al-nafisah/llm-kv260/docs/img/engine.pdf

## The engine on one board

Every token, the FPGA streams this board's quarter of the weights from DDR4 and multiplies it as it passes

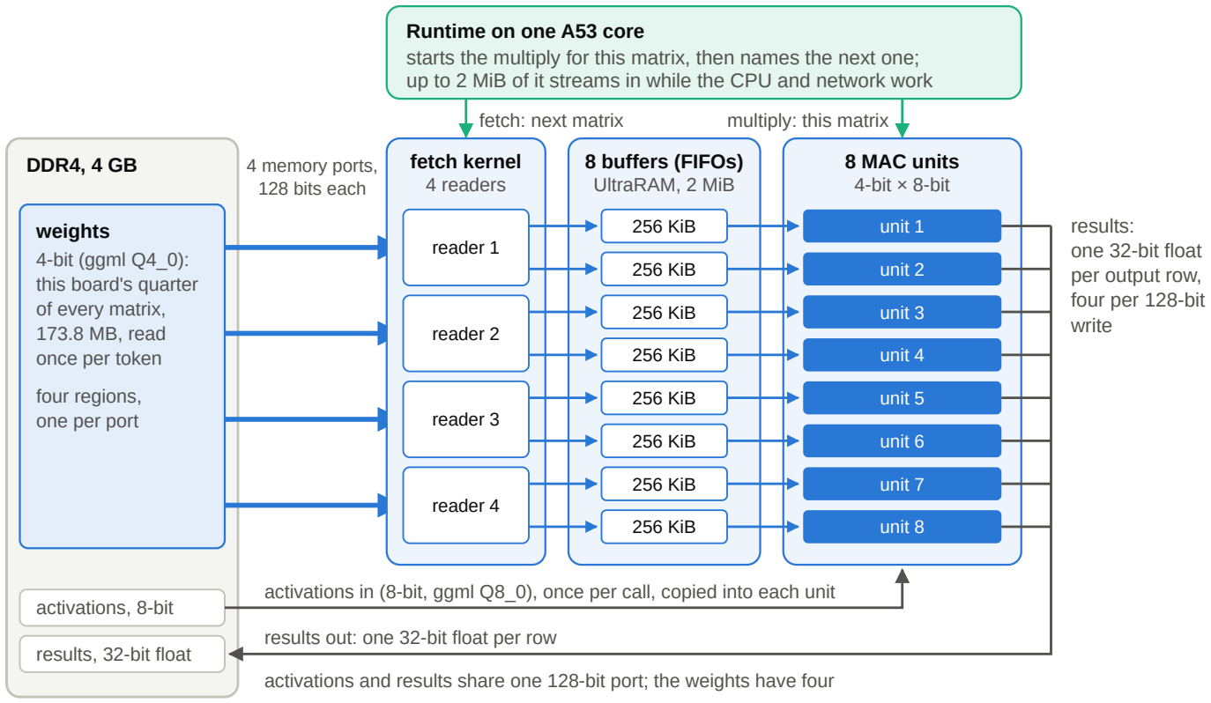
[picture p2: figure]
Runtime on one A53 core; fetch: next matrix; multiply: this matrix; DDR4, 4 GB; weights 4-bit (ggml Q4_0): this board's quarter of every matrix, 173.8 MB, read once per token; four regions, one per port; activations, 8-bit; results, 32-bit float; 4 memory ports, 128 bits each; fetch kernel 4 readers; reader 1; reader 2; reader 3; reader 4; 8 buffers (FIFOs) UltraRAM, 2 MiB; 256 KiB; 8 MAC units 4-bit × 8-bit; unit 1; unit 2; unit 3; unit 4; unit 5; unit 6; unit 7; unit 8; results out: one 32-bit float per row; results: one 32-bit float per output row, four per 128-bit write

starts the multiply for this matrix, then names the next one; up to 2 MiB of it streams in while the CPU and network work

activations in (8-bit, ggml Q8_0), once per call, copied into each unit

activations and results share one 128-bit port; the weights have four

Inside each MAC unit, for every block of 32 weights

32 × (4-bit × 8-bit) | integer sum | × two scales, 32-bit float | add into lane (block mod 8) | end of row: 8 lanes, fixed tree

The integer sum is exact in any order and the float order is fixed by the contract (src/llm_kv260/q4_0.py),
so the output is checked against it byte for byte: 9 of 9 test cases pass on each of the four boards (bench_gemv2).

gemv2 on the XCK26 (Vitis HLS and Vivado 2022.2), 250 MHz clock. Each reader deals alternate 144-byte chunks to its two buffers. Sources: hls/gemv2/, hw/kv260_gemv2/build.tcl, board/tp/tp_llama.cpp. Weights are a load-time copy of the GGUF's Q4_0 blocks.
