al-nafisah/llm-kv260/docs/img/scaling.pdf

## Rate and energy per token on 1, 2 and 4 boards

Each dot is one 400-token run; the open diamond is the same board without its engine (different software)

this project: runtime + FPGA engine, each run | same board, CPU only: llama.cpp, mean of 3 runs

Decode rate

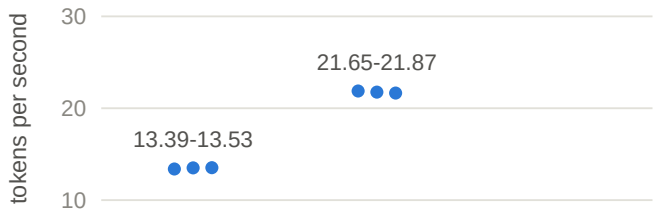
[picture p3: figure]
tokens per second

0

40

1 board

2 boards

4 boards

34.71-36.69

CPU only: 2.88 ± 0.07

Energy per generated token

0.0

0.5

1.0

1.5

2.0
joules per token (module power)

1 board
6.16-6.25 W

0.459-0.462 J

2 boards
11.59-11.68 W

0.530-0.539 J

4 boards
22.39-22.76 W

0.620-0.645 J

CPU only: 1.83 J at 5.28 W

Llama-3.2-1B-Instruct, every weight matrix ggml Q4_0, 400 generated tokens. Boards: run-tp.sh, 24-token prompt (positions 24-423), greedy, 3 runs each; medians 13.51, 21.75, 36.57 tokens/s, 1.61x on two boards and 2.71x on four.
CPU only: llama-bench on board 1's four A53 cores, tg400 from an empty context (positions 0-399), 2.88 ± 0.07 (mean ± s.d.). Power: the INA260 on each running K26 module, about 10 samples/s; carrier cards, fans, power supplies and the
switch are not measured. 2026-11-04, buildlog 0013; source: evidence/0013-tp-runs.txt, -power-*, -cpu-llama-bench.txt.
