al-nafisah/llm-kv260/docs/img/system.pdf

## Four boards, one token stream

Each board holds a quarter of every weight matrix; all four work on the same token at the same time

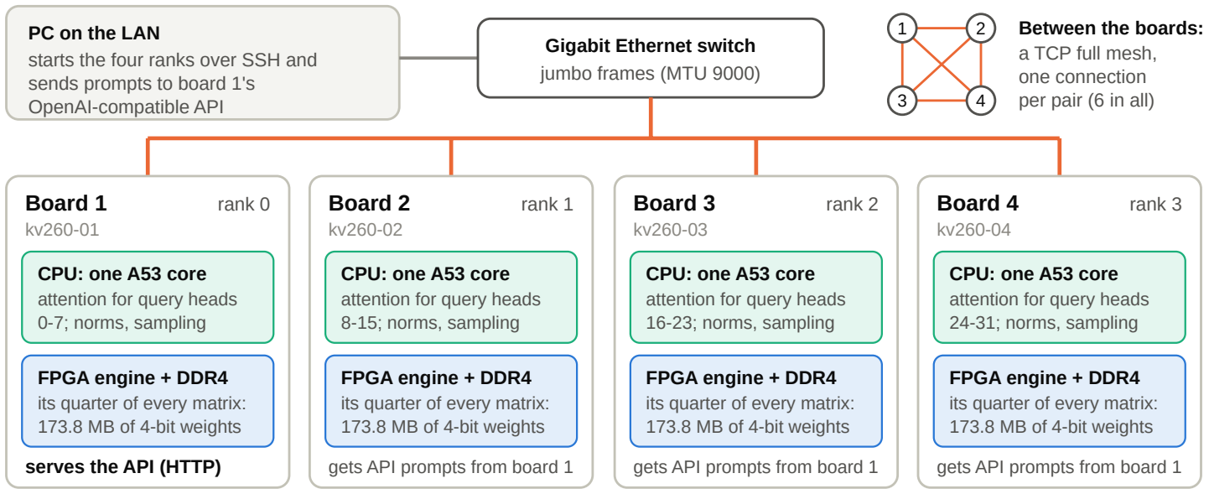
[picture p4: figure]
PC on the LAN starts the four ranks over SSH and sends prompts to board 1's OpenAI-compatible API; Gigabit Ethernet switch jumbo frames (MTU 9000); Between the boards: a TCP full mesh, one connection per pair (6 in all); Board 1; rank 0; CPU: one A53 core attention for query heads 0-7; norms, sampling; FPGA engine + DDR4 its quarter of every matrix: 173.8 MB of 4-bit weights; serves the API (HTTP); Board 2; rank 1; CPU: one A53 core attention for query heads 8-15; norms, sampling; gets API prompts from board 1; Board 3; rank 2; CPU: one A53 core attention for query heads 16-23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

How a weight matrix is split across the four boards

1
2
3
4
× | =
weights | input output

By output rows
q, k, v, gate, up and the
output head (lm_head):
each board computes its own quarter of the outputs,
with no all-reduce
1 | 2 | 3 | 4 | × | =
weights | input output

By input columns
attention output, FFN down: each board has a partial sum of every output; an all-reduce adds the four in board order, the same way on every board
then once per token: | output head (lm_head) | argmax exchange | next token, the same on all four boards

33 exchanges per token: 2 all-reduces in each of the 16 layers, plus 1 argmax exchange.
engine (FPGA) | exchange (network) | CPU (one A53 core)

Llama-3.2-1B-Instruct, every weight matrix ggml Q4_0: 695.1 MB of weights per token, 173.8 MB per board on four. Runtime: board/tp/tp_llama.cpp. Partial sums are added in rank order on every board, so all four hold the same hidden state.
