al-nafisah/llm-kv260/docs/img/token.pdf

## Where one token's time goes

Time per generated token on board 1 (rank 0), three runs for each board count

Engine (matrix-vector calls on the FPGA) | Exchange (network) | CPU (one A53 core)
0 | 10 | 20 | 30 | 40 | 50 | 60 | 70 | 80
milliseconds per generated token

### 1 board

exchange 0.2 ms

run 1 | 53.4 | 22.9 | 13.39 tokens/s
run 2 | 53.4 | 22.1 | 13.51 tokens/s
run 3 | 53.4 | 22.0 | 13.53 tokens/s

### 2 boards

run 1 | 22.4 | 12.4 | 11.9 | 21.87 tokens/s
run 2 | 22.4 | 12.7 | 11.8 | 21.75 tokens/s
run 3 | 22.4 | 12.9 | 11.8 | 21.65 tokens/s

### 4 boards

run 1 | 10.0 | 12.7 | 6.3 | 34.71 tokens/s
run 2 | 10.0 | 11.4 | 6.1 | 36.69 tokens/s
run 3 | 10.0 | 11.7 | 5.9 | 36.57 tokens/s

Llama-3.2-1B-Instruct, every weight matrix ggml Q4_0. run-tp.sh, 400 tokens generated after a 24-token prompt (positions 24-423), greedy; gemv2 bitstream at 250 MHz; rank 0's buckets: all 423 forwards,
prompt included, over the 400 tokens (about 6% high). Engine time includes preparing each call's input on the CPU. 2026-11-04, buildlog 0013; source: evidence/0013-tp-runs.txt.
