al-nafisah/llm-kv260/docs/img/engine.png

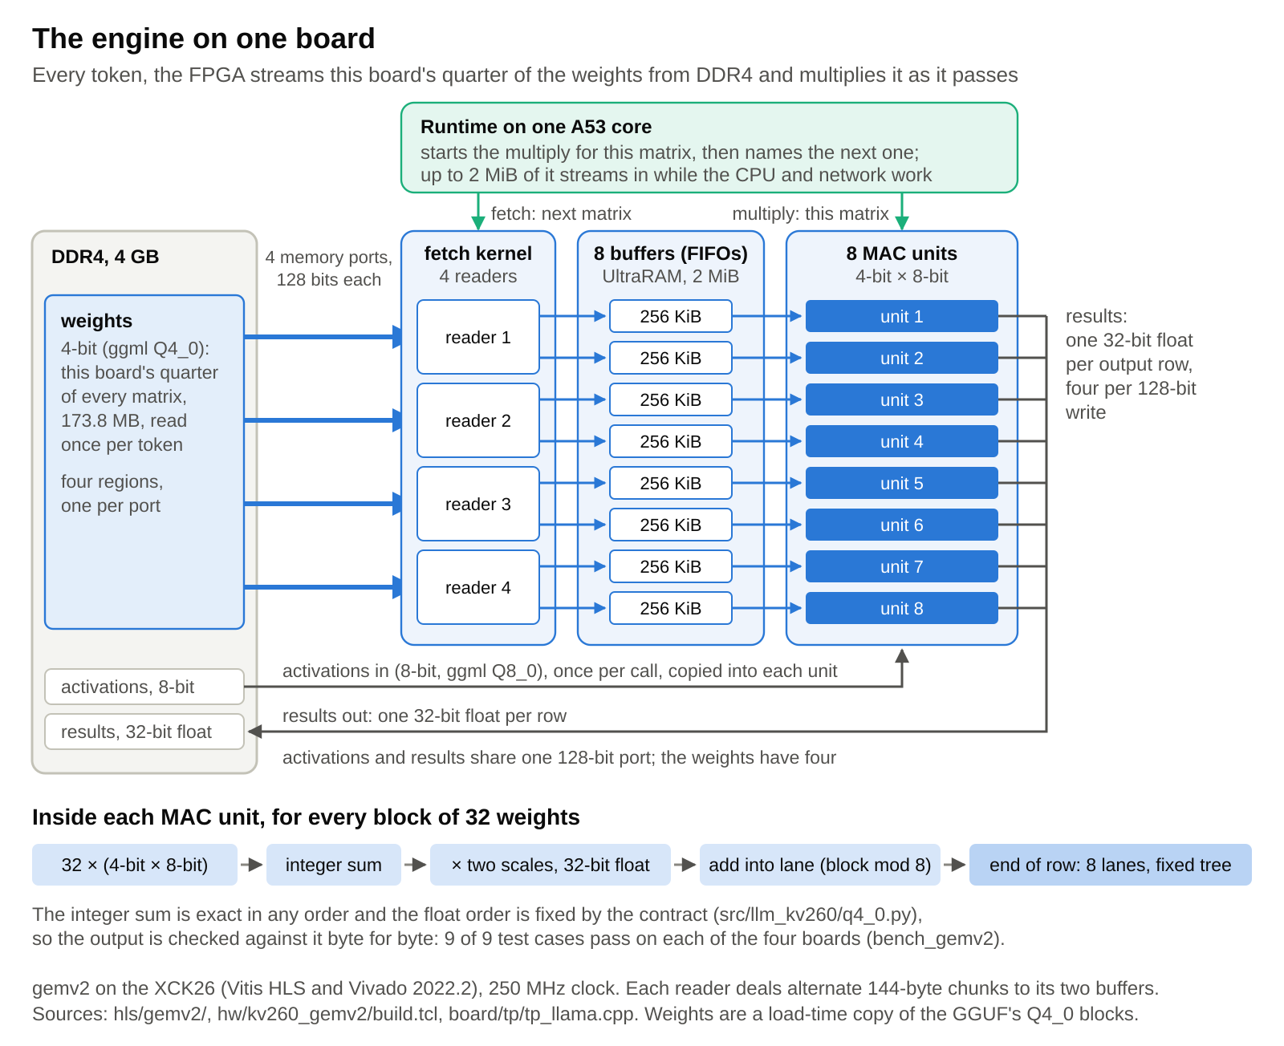
docs/img/engine.png
