al-nafisah/llm-kv260/docs/img/scaling.png

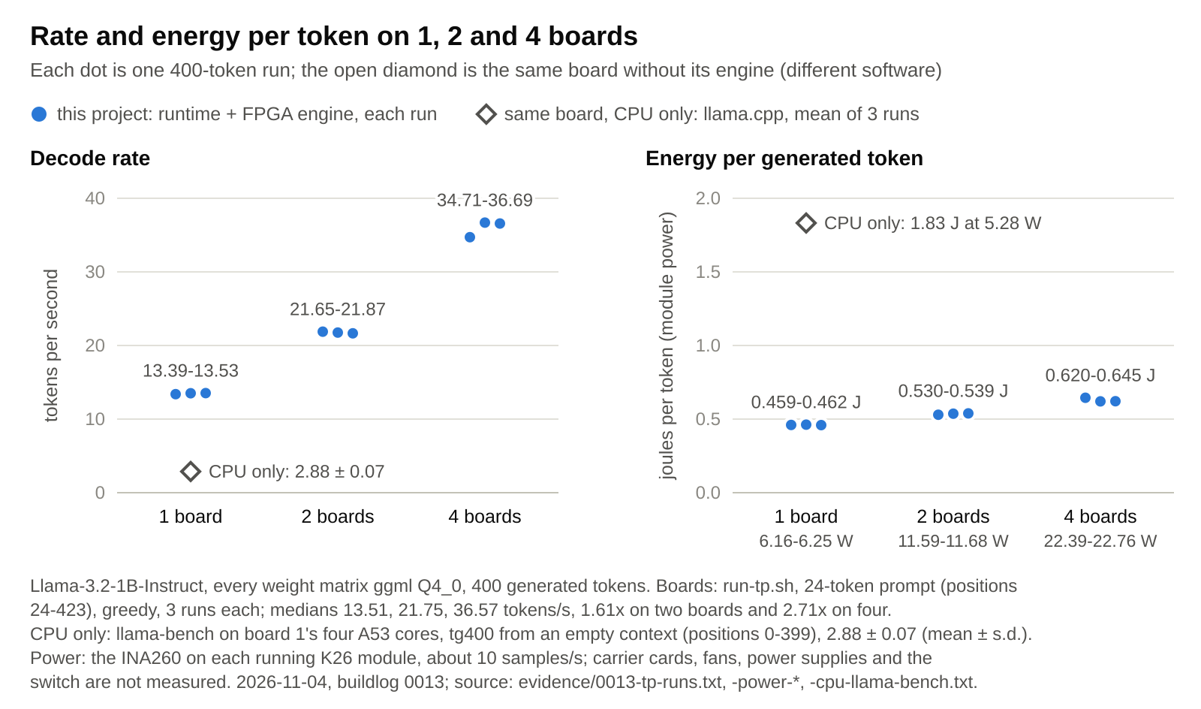
docs/img/scaling.png
