al-nafisah/llm-kv260/docs/img/system.png

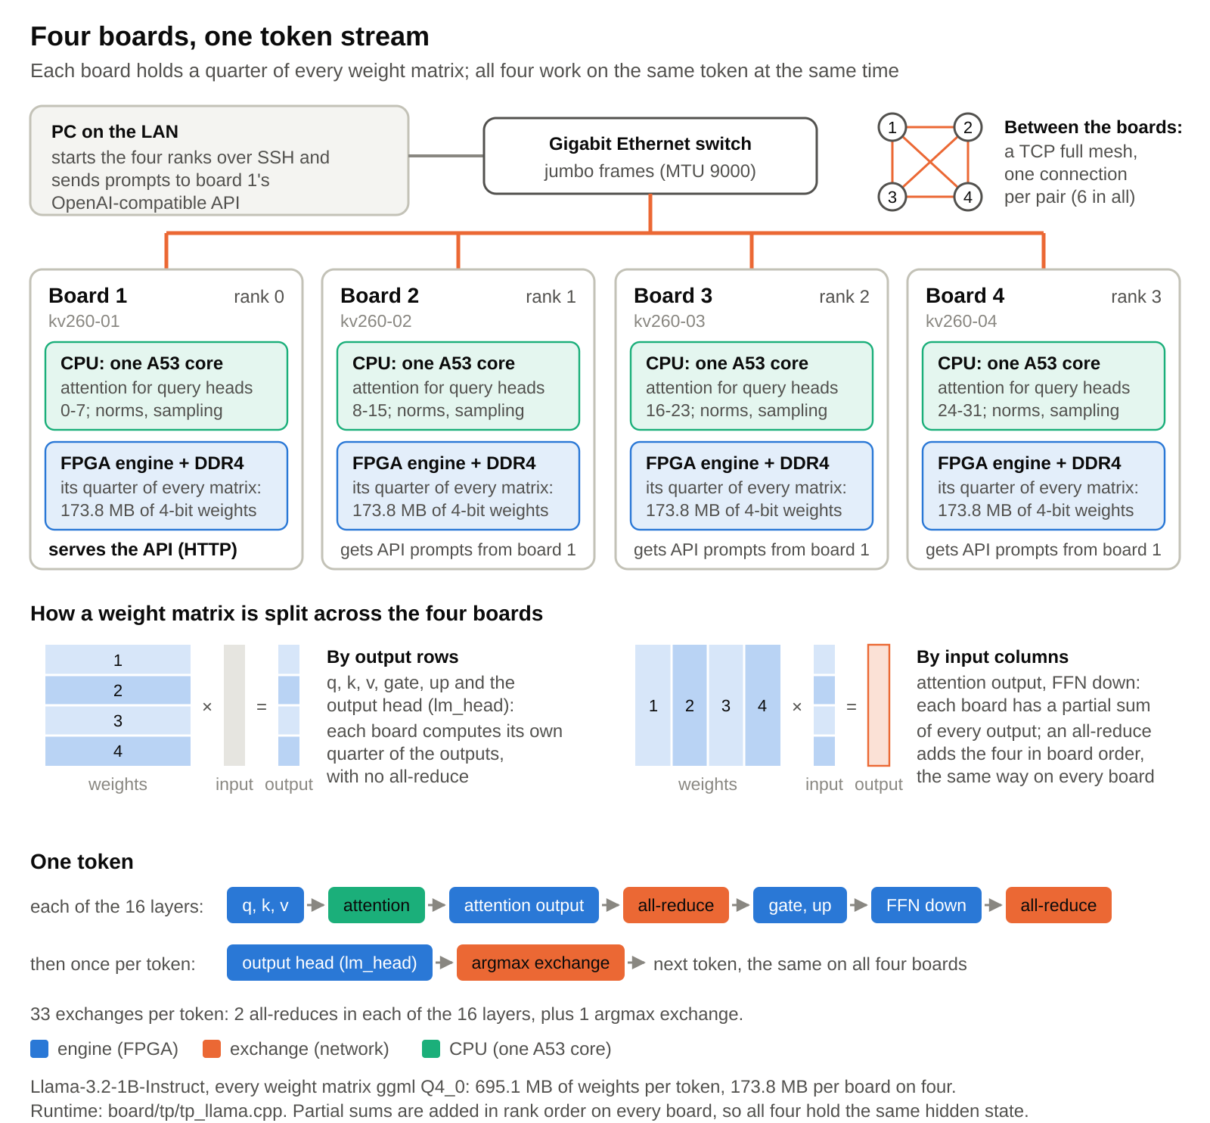
docs/img/system.png
