al-nafisah/llm-kv260/docs/img/token.png

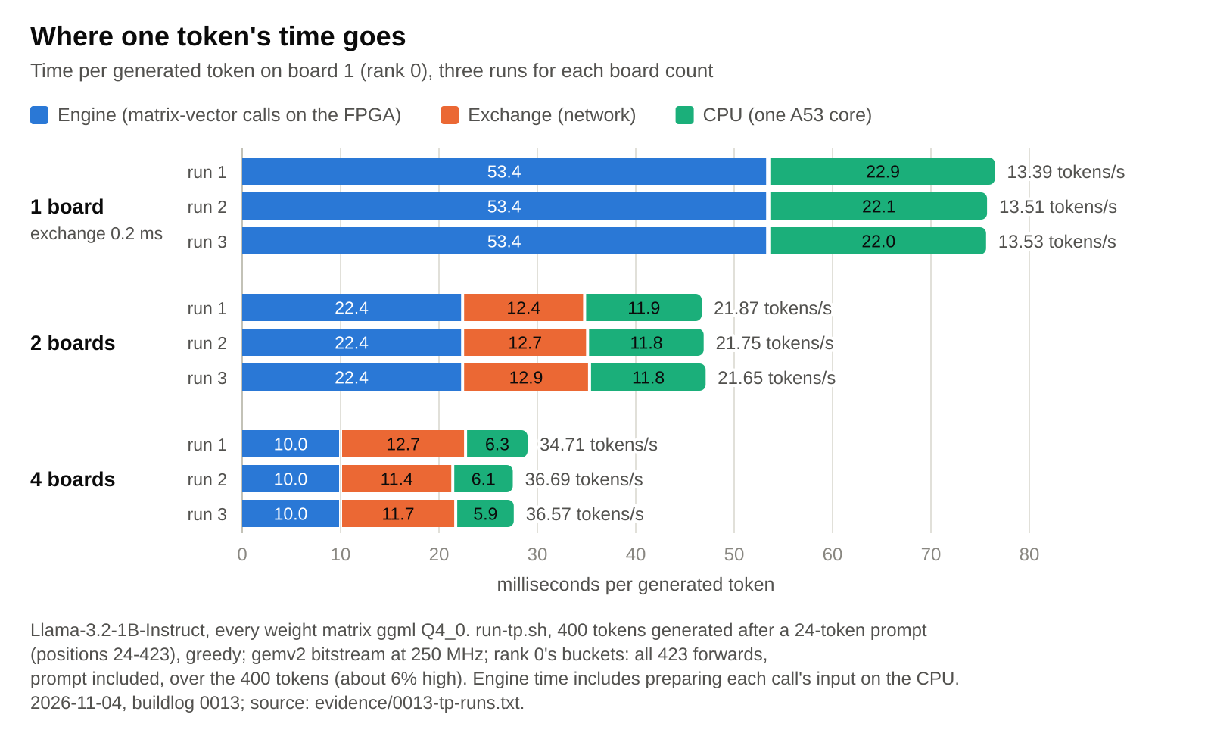
docs/img/token.png
