al-nafisah/llm-kv260/enclosure/previews/kv_fascia.png

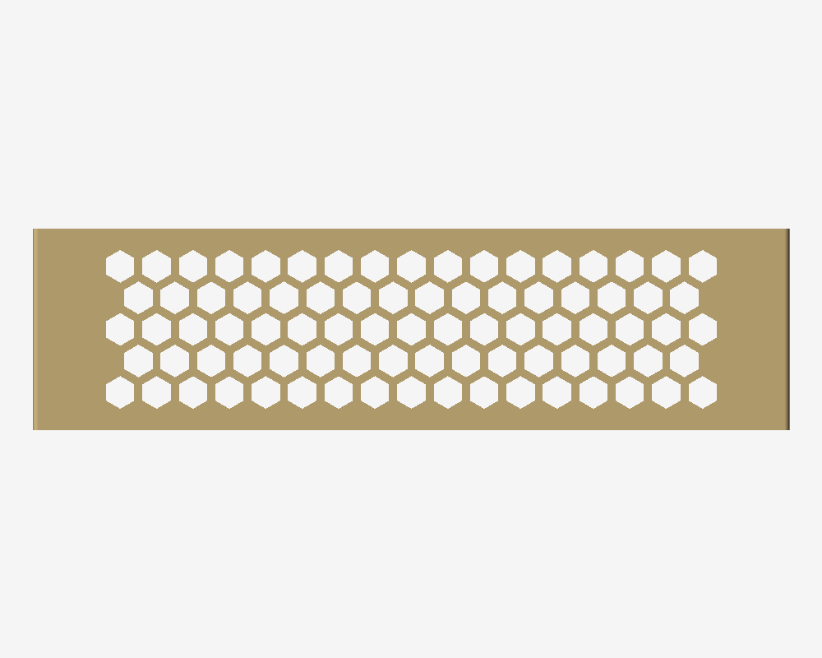
enclosure/previews/kv_fascia.png
