al-nafisah/llm-kv260/enclosure/previews/kv_tray.png

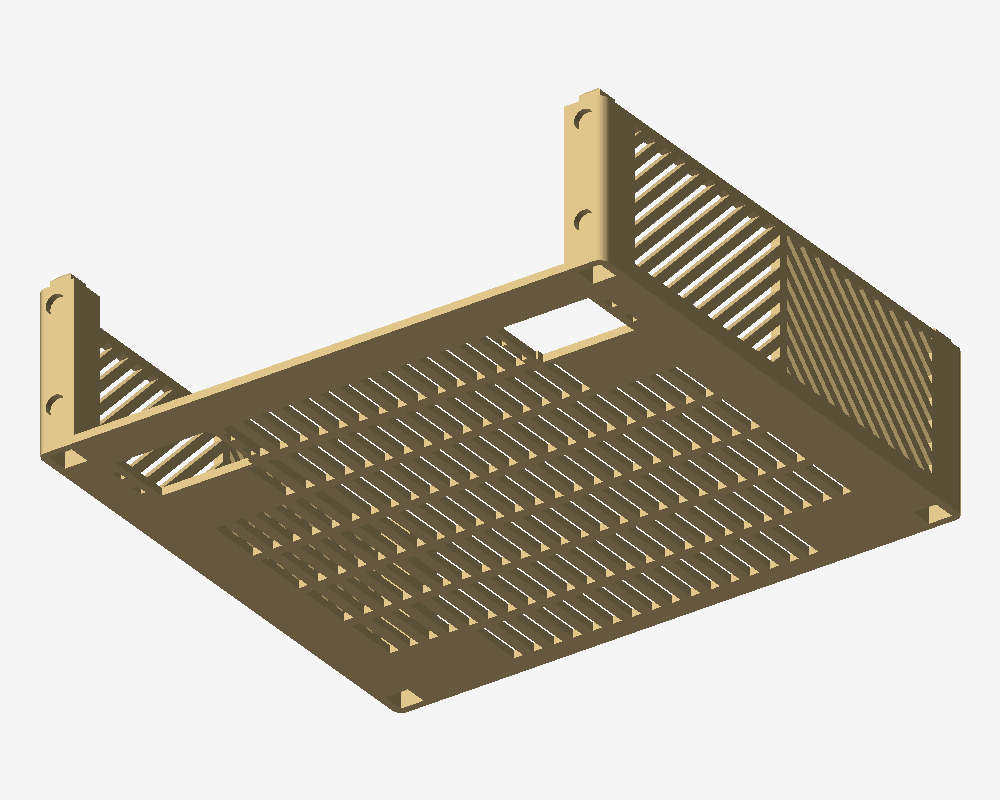
enclosure/previews/kv_tray.png
