al-nafisah/llm-kv260/enclosure/previews/kv_tray_side.png

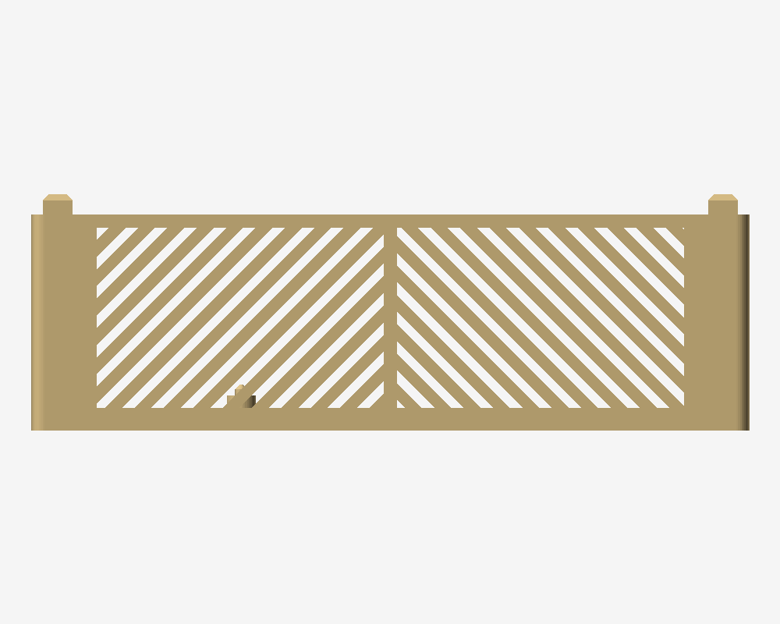
enclosure/previews/kv_tray_side.png
