al-nafisah/llm-kv260/enclosure/previews/switch_tray.png

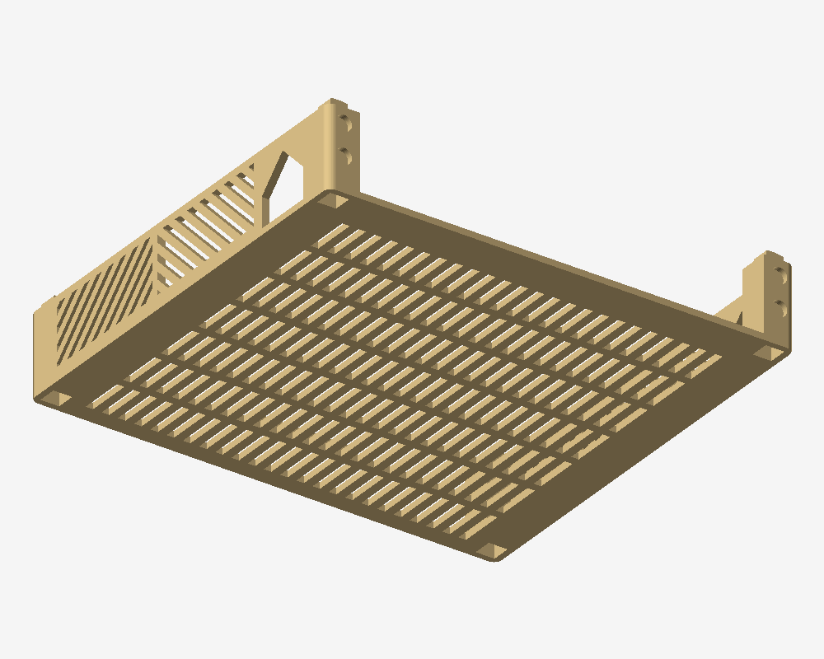
enclosure/previews/switch_tray.png
