al-nafisah/llm-kv260/enclosure/previews/top_cap.png

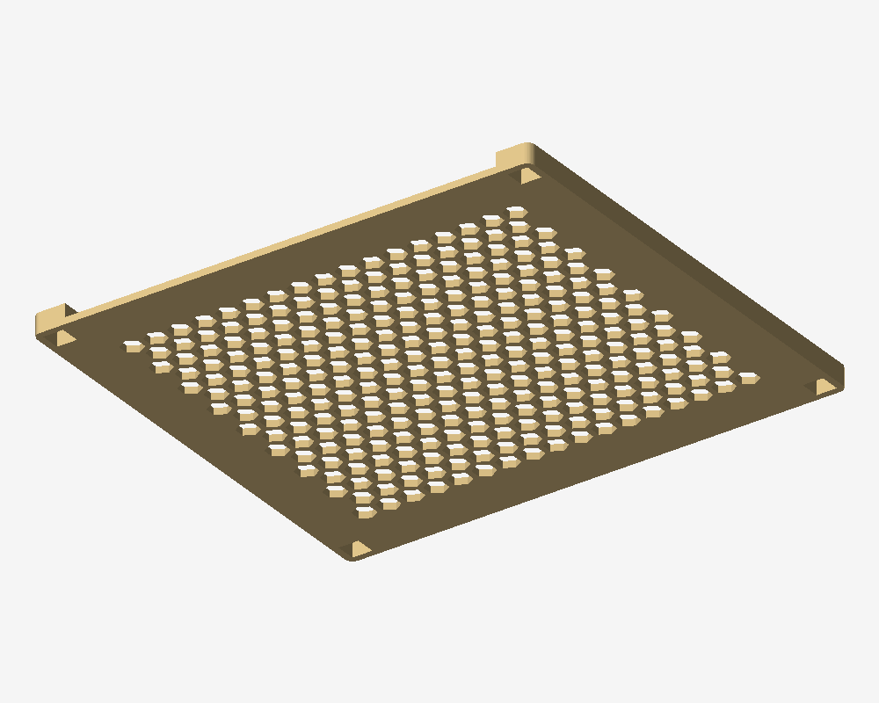
enclosure/previews/top_cap.png
