al-nafisah/llm-kv260/enclosure/stl/kv_tray.stl

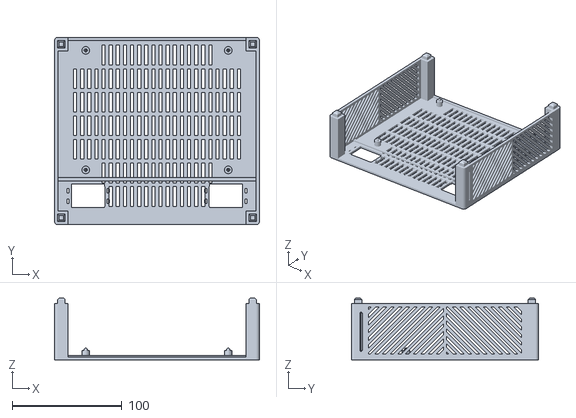
[picture p14: CAD file, 2026-09-29]
enclosure/stl/kv_tray.stl
187.0 x 171.0 x 56.5
