al-nafisah/llm-kv260/enclosure/stl/top_cap.stl

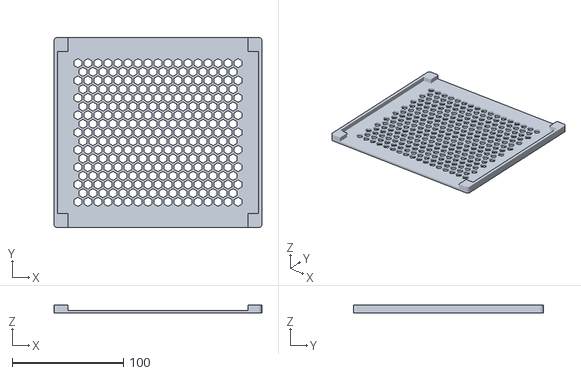
[picture p15: CAD file, 2026-09-29]
enclosure/stl/top_cap.stl
187.0 x 171.0 x 7.50
