al-nafisah/llm-kv260/enclosure/stl/switch_tray.stl

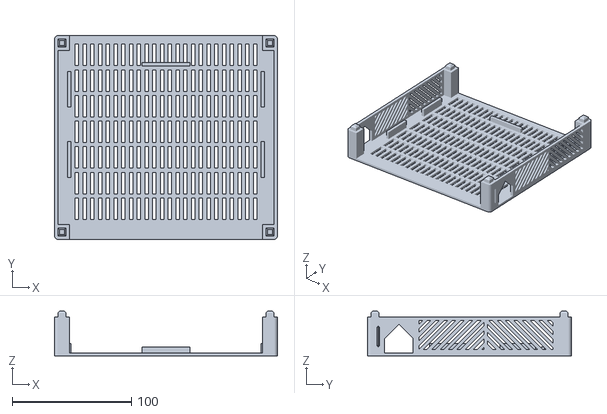
[picture p16: CAD file, 2026-09-29]
enclosure/stl/switch_tray.stl
187.0 x 171.0 x 37.5
