al-nafisah/llm-kv260/enclosure/stl/kv_fascia.stl

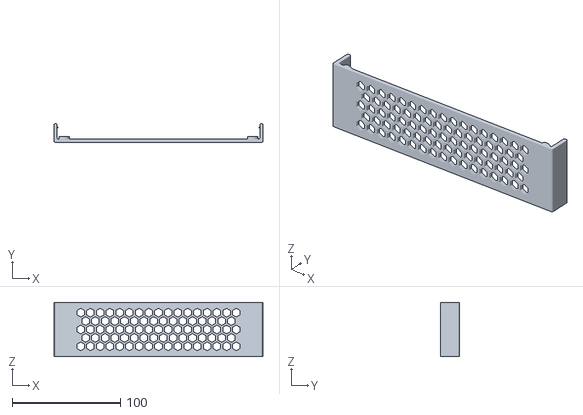
[picture p17: CAD file, 2026-09-29]
enclosure/stl/kv_fascia.stl
193.5 x 17.3 x 50.0
