al-nafisah/llm-kv260/enclosure/stl/sw_fascia.stl

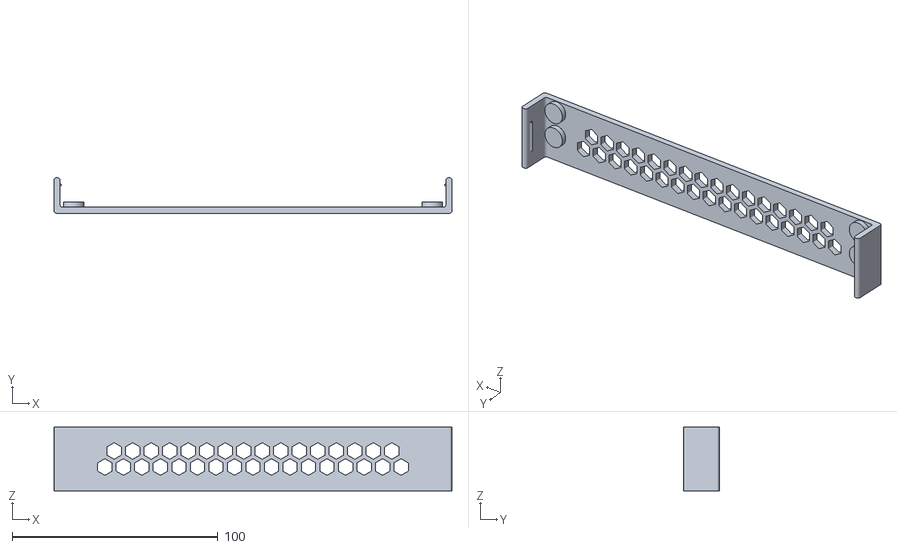
[picture p18: CAD file, 2026-09-29]
enclosure/stl/sw_fascia.stl
193.5 x 17.3 x 31.0
