al-nafisah/llm-kv260/enclosure/previews/assembly_front.png

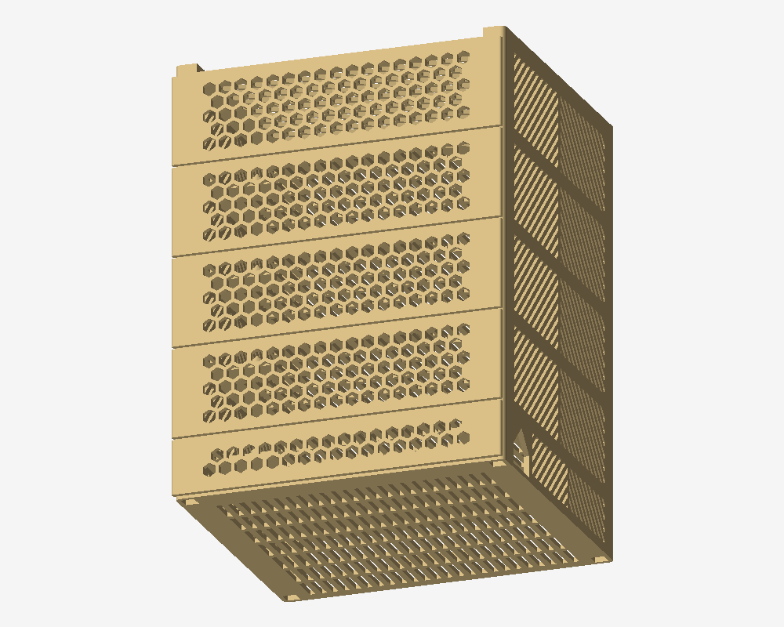
enclosure/previews/assembly_front.png
