al-nafisah/llm-kv260/enclosure/previews/assembly_iso.png

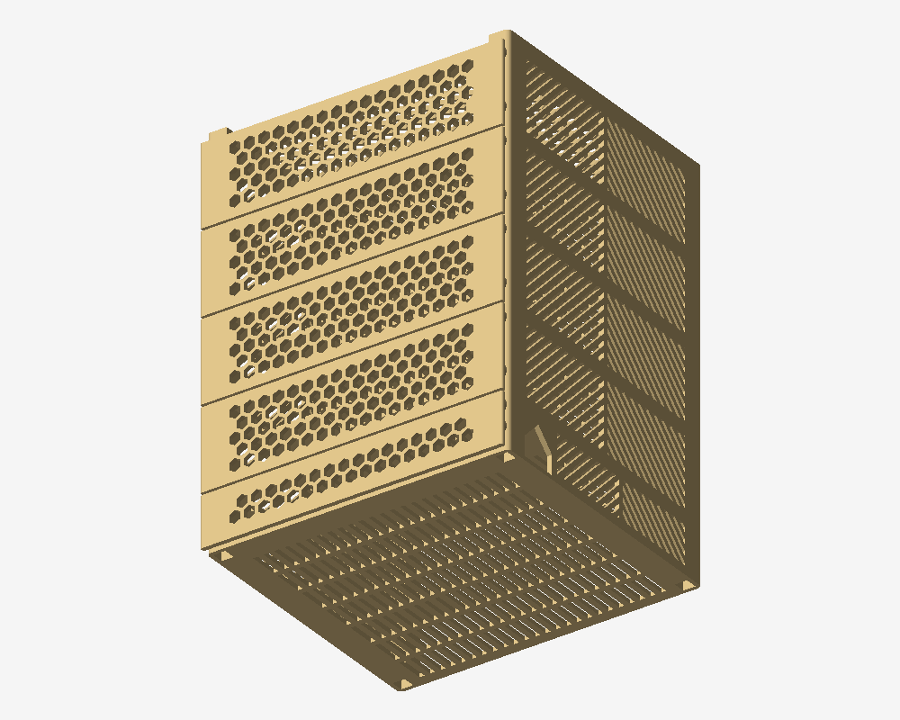
enclosure/previews/assembly_iso.png
