al-nafisah/llm-kv260/enclosure/previews/print_layout.png

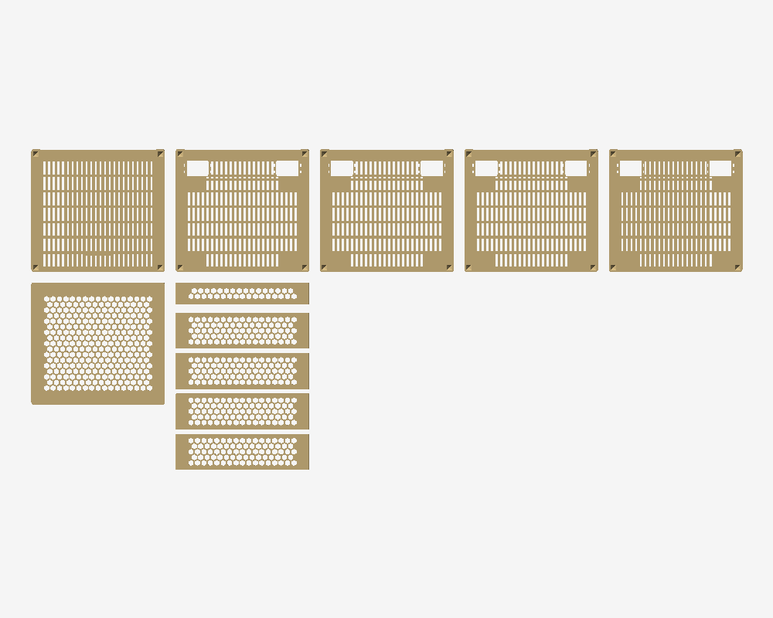
enclosure/previews/print_layout.png
