al-nafisah/llm-kv260/(commit log)

2026-09-14 Contract: the bit-exact definition of one int4 matvec
    ggml Q4_0 weights against Q8_0 activations: an int32 dot per block, two
    float32 multiplies, eight sequential lanes, then a binary tree. Integer
    in-block accumulation is what makes bit-exactness free.
    Every stage after this one is checked against this module, and the tests
    hold its golden hash. One differing byte is a failure, with no tolerance.
2026-09-17 Driver: u-dma-buf memory, UIO registers, and the exactness bench
    About 200 lines of C and no framework: contiguous memory from CMA with its
    physical address, explicit cache maintenance from user space, and four
    independent weight addresses per call so the quarters can sit at distinct
    offsets modulo 64 KB.
    bench_gemv2 proves the engine against the contract's vectors, then measures
    cold and prefetched GB/s.
2026-09-17 Runtime: NEON on one core, four boards on one stream
    Everything between the matmuls in NEON intrinsics on one A53, tensor
    parallel across four boards over a TCP full mesh: two all-reduces a layer,
    one argmax exchange a token, and no traffic for attention because a rank
    owns the query heads its KV shard serves.
    Partials sum in rank order on every rank, so the hidden state stays
    bit-identical and all four ranks print the same text. Rank 0 serves the
    OpenAI-compatible API, one prompt at a time in arrival order.
2026-09-17 Bringup: first login, the overlay, and the settings a reboot drops
    One kit and one script take a blank card to a board that passes the
    exactness check.
    The overlay, the memory pools and the AXI width have to be reloaded after
    every reboot. MTU 9000 and the unbound DisplayPort survive one, and both
    matter: the display subsystem raises 10,500 interrupts a second on CPU 0
    with no monitor attached.
2026-09-20 Page: a public chat and four live board cards
    A static page on GitHub Pages, the boards behind a Cloudflare named tunnel
    and a logging proxy on the PC.
    The cards read /stats: the per-token split between fabric, exchange and
    CPU, memory bandwidth over the whole token, power from each module's
    INA260, temperature and RAM.
2026-09-22 Docs: the design, the runbook, and buildlogs 0006 to 0012
    Every number measured here, with its raw log under docs/buildlog/evidence/.
    Attested and cited numbers never blend, and a failed build is a result.
    The runbook carries the traps, each of which cost a session once: the AXI
    width, the fragmented CMA, netplan apply killing NetworkManager, a UFW rule
    taking all four boards down at once.
2026-09-22 Page: a Pipeline card, the token loop and one board's AXI fabric
    A second fold under Resources with two inline SVGs. The first is the
    per-token loop every board runs: prompt, tokenize and broadcast, embed,
    the sixteen-layer body with its four engine calls and two all-reduces,
    lm_head, the candidate all-gather, the sampler, and the token feeding
    back. The three other boards are a rail beside it, joined at the
    exchanges. The second is one board: DDR4 and the A53 on the PS side,
    gemv_fetch, the eight UltraRAM FIFOs and gemv_mac on the PL side, with
    every AXI link named with its width and what it carries.
    Colours are the page's three per-token buckets, and the numbers are the
    last chat's averag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
2026-09-23 Page: the Resources cards count the gemv2 build, and show its UltraRAM
    The per-board LUT, DSP and BRAM figures were the gemv_q4_0 engine's from
    buildlog 0006: 32,228 / 228 / 48. The boards run gemv2: 58,268 LUT (50%),
    456 DSP (37%), 76 BRAM (53%), and all 64 UltraRAM, which the cards did
    not show at all (docs/buildlog/evidence/0012-gemv2-vivado-utilization.txt).
2026-09-24 Page: the Pipeline card's text takes the theme colour
    SVG text does not inherit the page's colour: its default fill is black,
    so in the dark theme every label in both panels sat black on the dark
    card. The strokes already used currentColor; now the root of each SVG
    does too, and the text inherits it in either theme.
2026-09-29 Enclosure: the stacking tower for the four boards and the switch
    [kria_tower.scad, kv_fascia.stl, kv_tray.stl, sw_fascia.stl, switch_tray.stl, top_cap.stl]
2026-10-09 Board: recover.sh brings the stream back after a power cut
    One command from the PC: wait for the four boards to answer, load the gemv2
    overlay and the pools wherever they are missing, restart the ranks, and
    check the public API with a real chat. It relies on the sudoers rule that
    now lets every board run load-overlay.sh without a password, which was the
    one step that used to need a hand.
    Claude-Session: https://claude.ai/code/session_015ops2xbixVud8cTBD9n7a5
2026-11-04 Board: the API stays on the LAN, with a terminal chat and a local page
    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
2026-11-04 Buildlog 0013: rate, module power and a CPU baseline from one recorded session
    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
2026-11-04 Docs: corrections from the release review, and CLAUDE.md for a LAN-only system
    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
    [tp_llama.cpp]
